lannisraurus/afm-tools/README.md

# Programme Flowchart

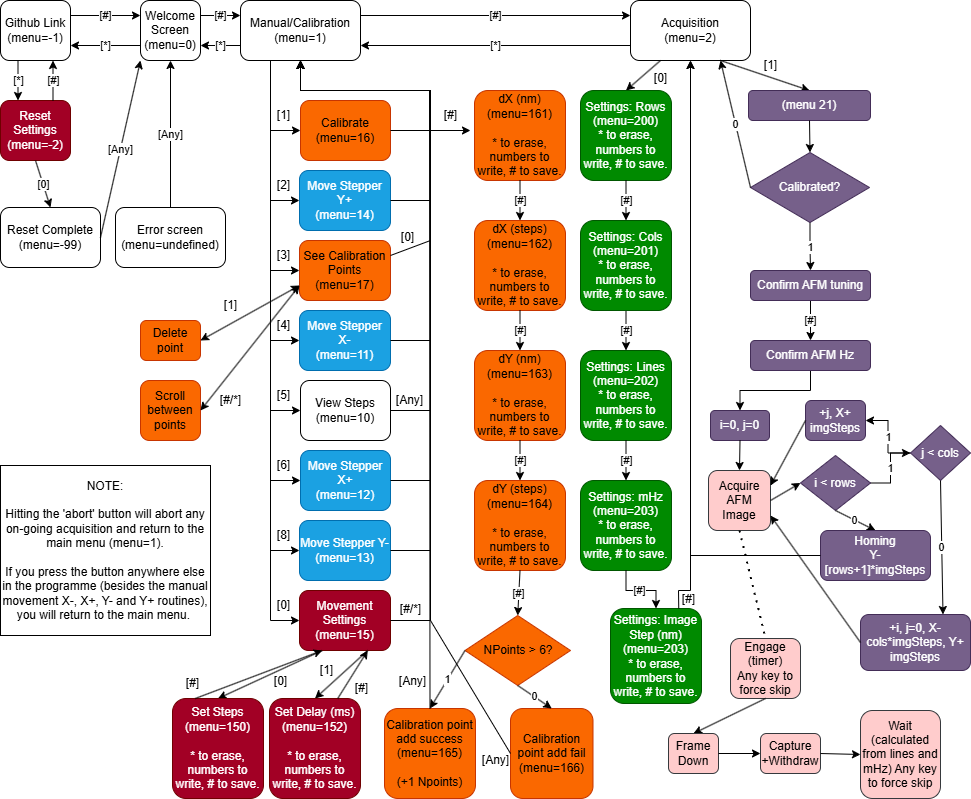
[picture p1: Models/flowchart.png]
Flowchart
