lannisraurus/afm-tools/Presentation.pdf

Automated High-Range AFM Image Acquisition

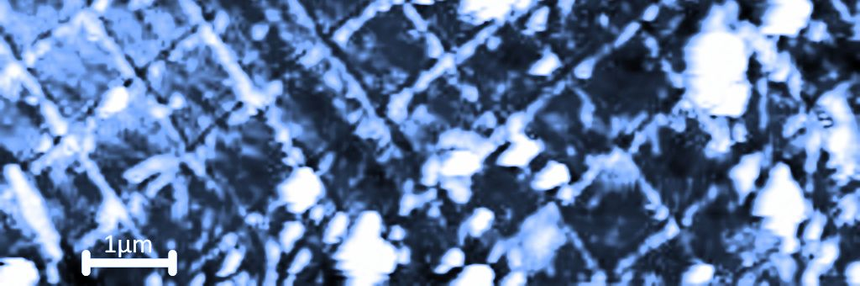
[picture p2: figure]

1st Cycle Integrated Project in Engineering Physics - Scientific Project João Francisco Oliveira Camacho (ist1106224)
Supervisor: Prof. Dr. Luís Humberto Viseu Melo

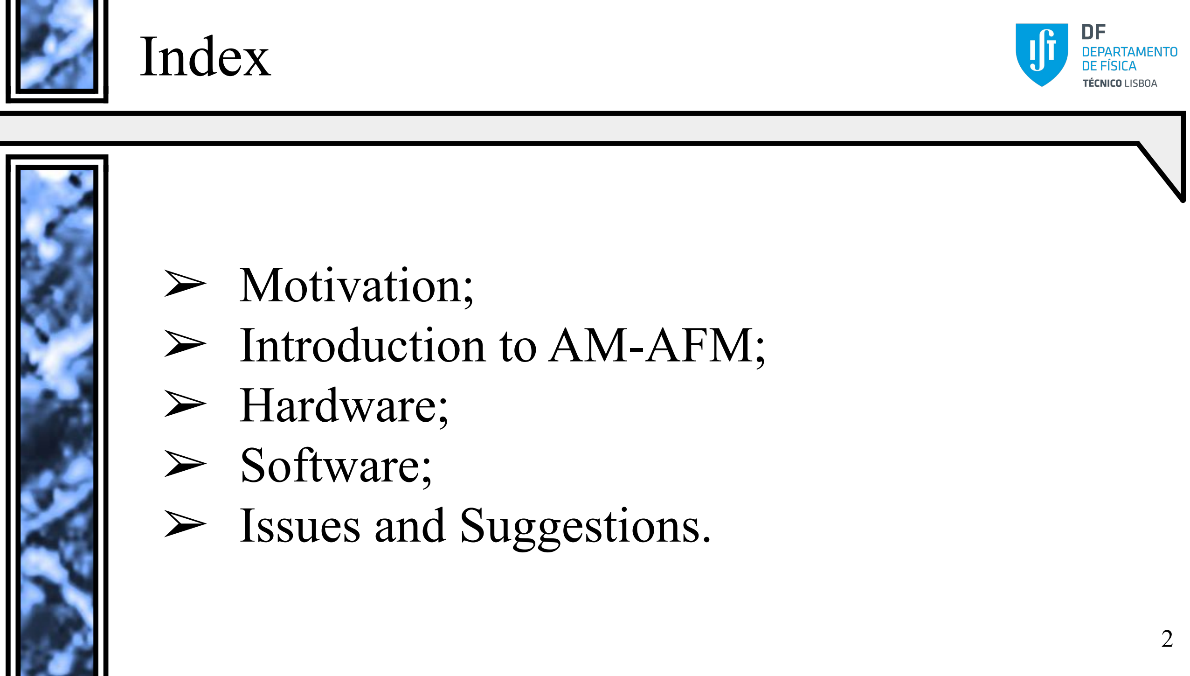
[picture p3: figure]
Index; ➢ Motivation; ➢ Introduction to AM-AFM; ➢ Hardware; ➢ Software; ➢ Issues and Suggestions.
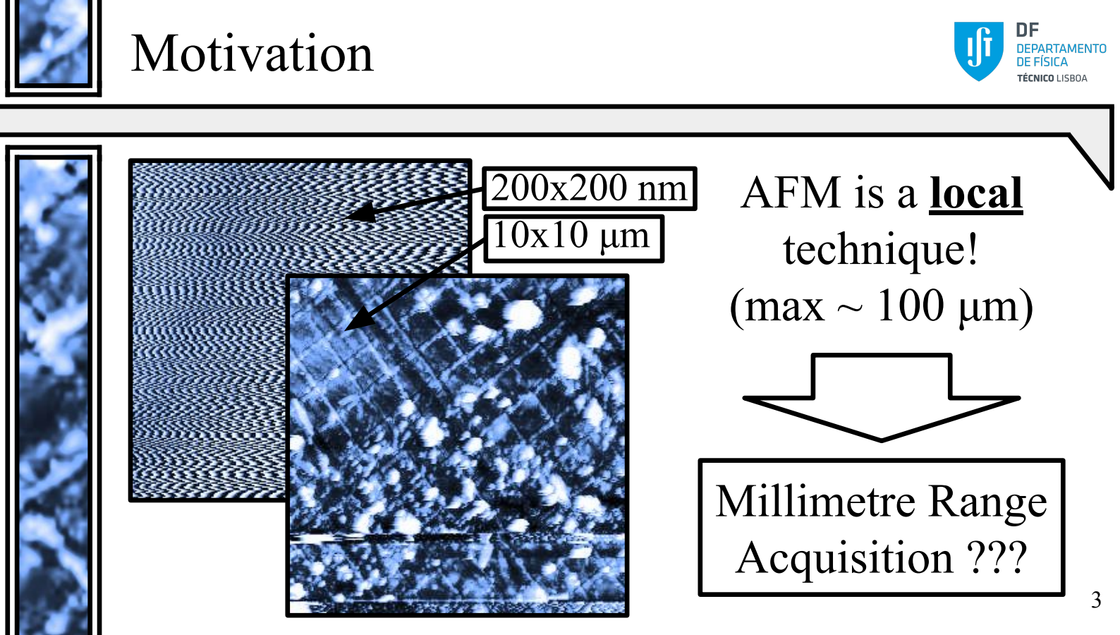
[picture p4: page 3]

### Motivation

AFM is a local
technique!
(max ~ 100 μm)

200x200 nm
10x10 μm

Millimetre Range
Acquisition ???

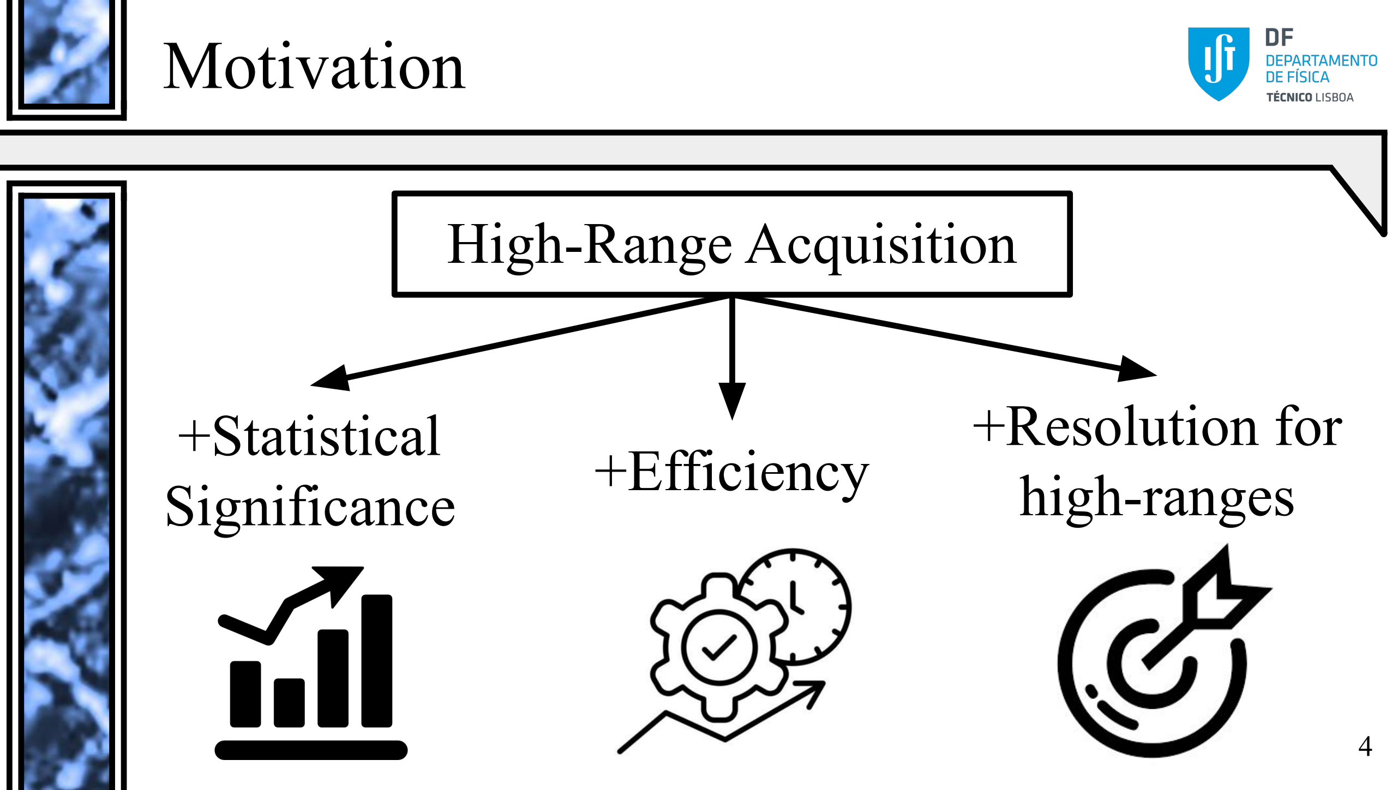
[picture p5: figure]
Motivation; High-Range Acquisition; +Statistical; Significance; +Efficiency; +Resolution for high-ranges
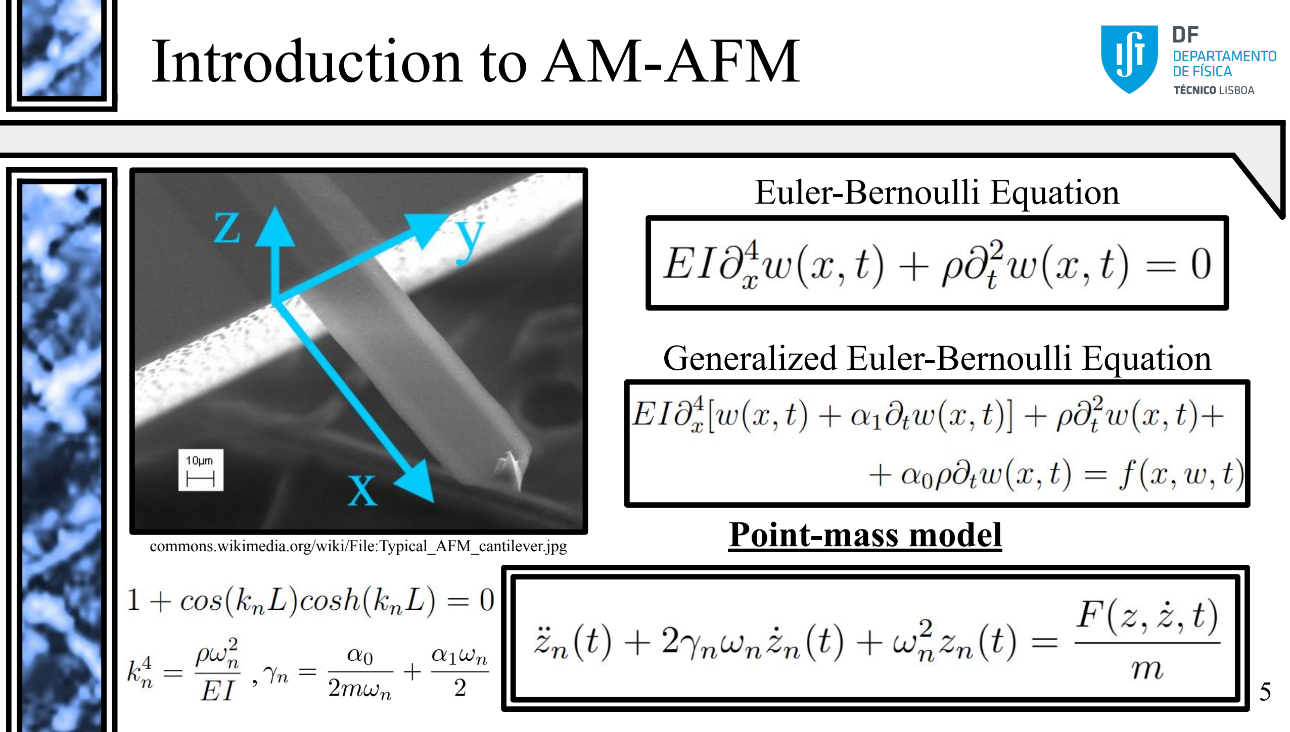
[picture p6: page 5]

### Introduction to AM-AFM

commons.wikimedia.org/wiki/File:Typical_AFM_cantilever.jpg

Euler-Bernoulli Equation

Generalized Euler-Bernoulli Equation

Point-mass model

,

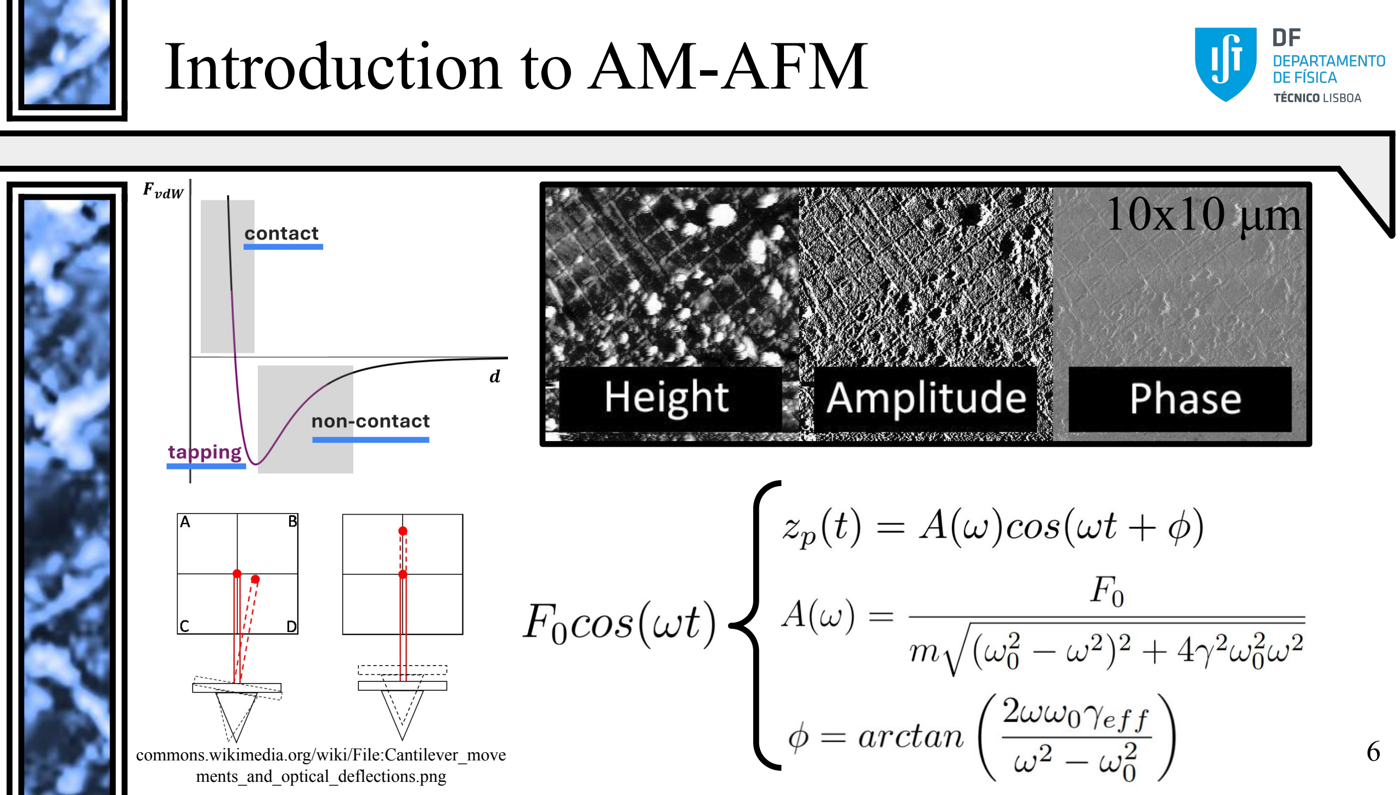
[picture p7: page 6]

### Introduction to AM-AFM

commons.wikimedia.org/wiki/File:Cantilever_move ments_and_optical_deflections.png

10x10 μm

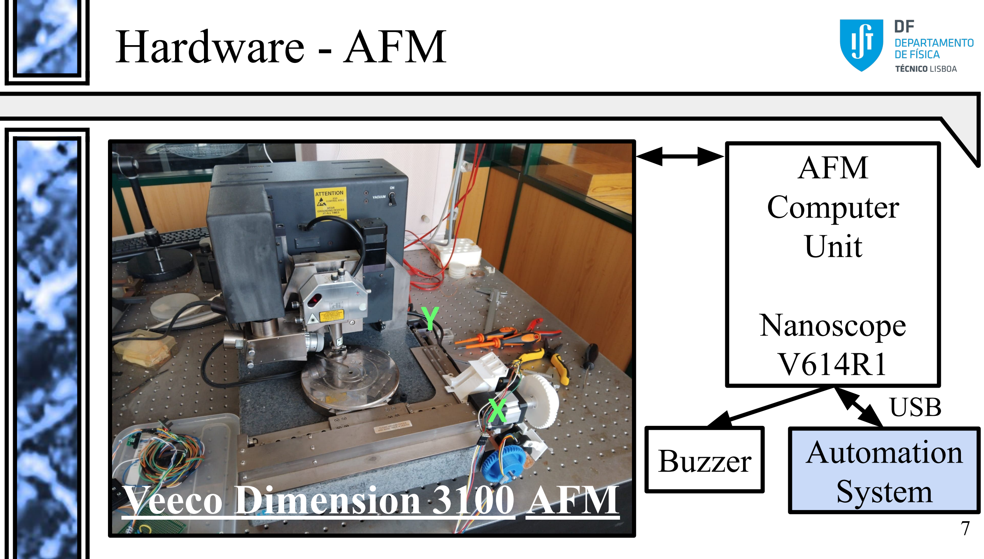
[picture p8: page 7]

### Hardware - AFM

Veeco Dimension 3100 AFM

AFM
Computer
Unit

Nanoscope
V614R1
Buzzer Automation System USB

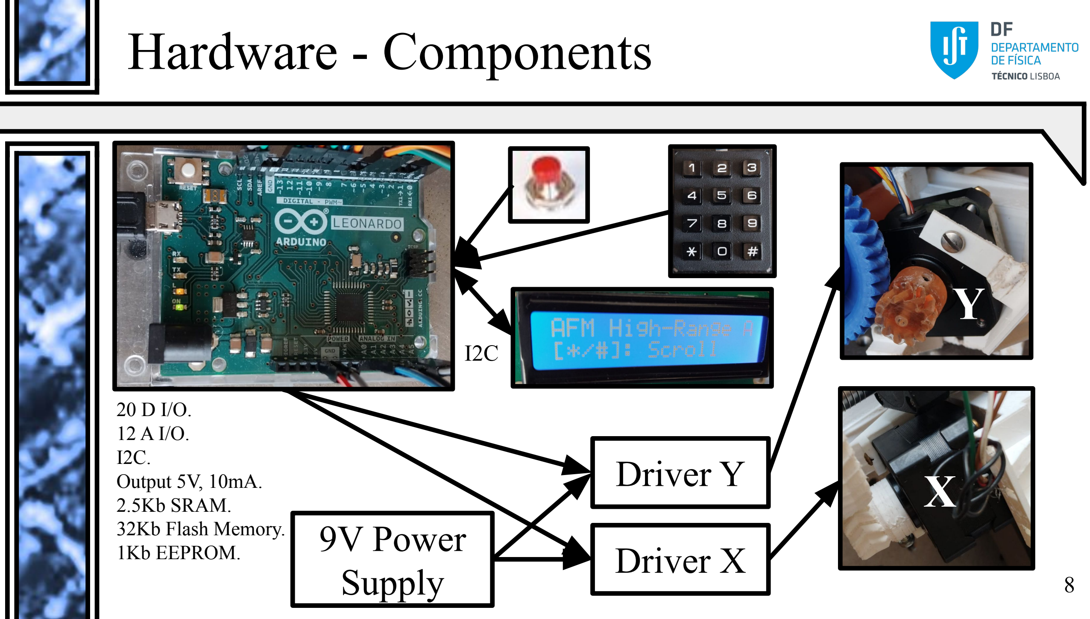
[picture p9: figure]
Hardware - Components; 20 D I/O. 12 A I/O. I2C. Output 5V, 10mA. 2.5Kb SRAM. 32Kb Flash Memory. 1Kb EEPROM.; 9V Power Supply; Driver Y; Driver X
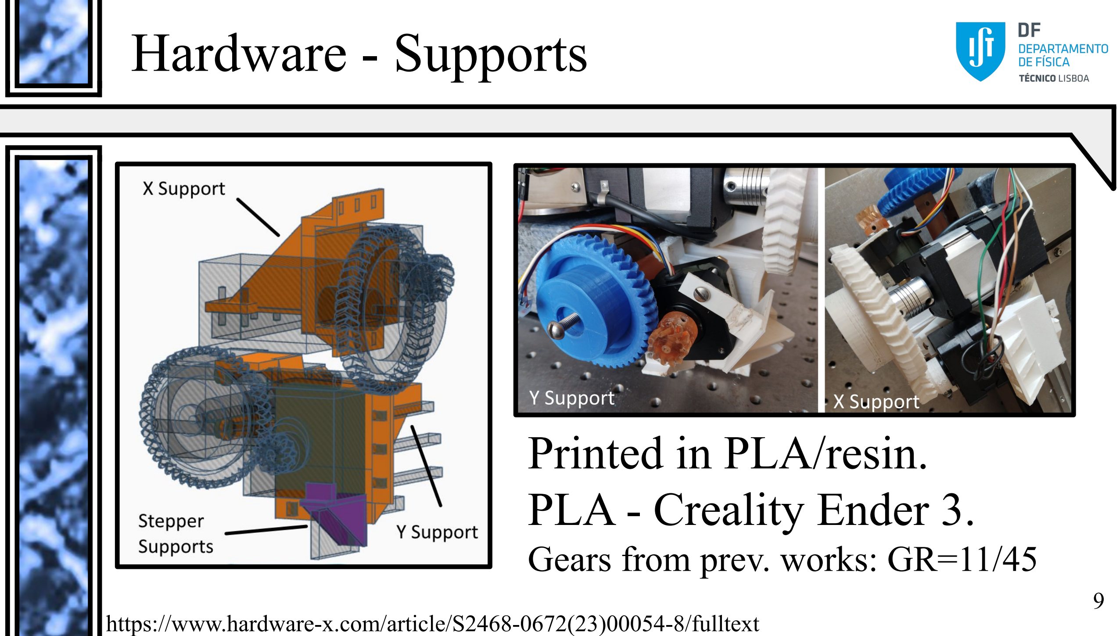
[picture p10: page 9]

### Hardware - Supports

X

Y

Printed in PLA/resin.
PLA - Creality Ender 3.
Gears from prev. works: GR=11/45

https://www.hardware-x.com/article/S2468-0672(23)00054-8/fulltext

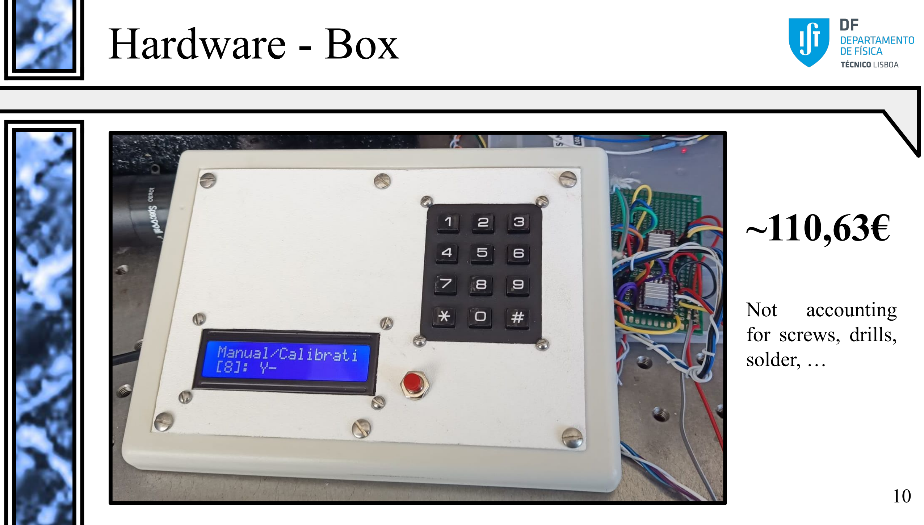
[picture p11: figure]
Hardware - Box; Not; accounting; for screws, drills, solder, …

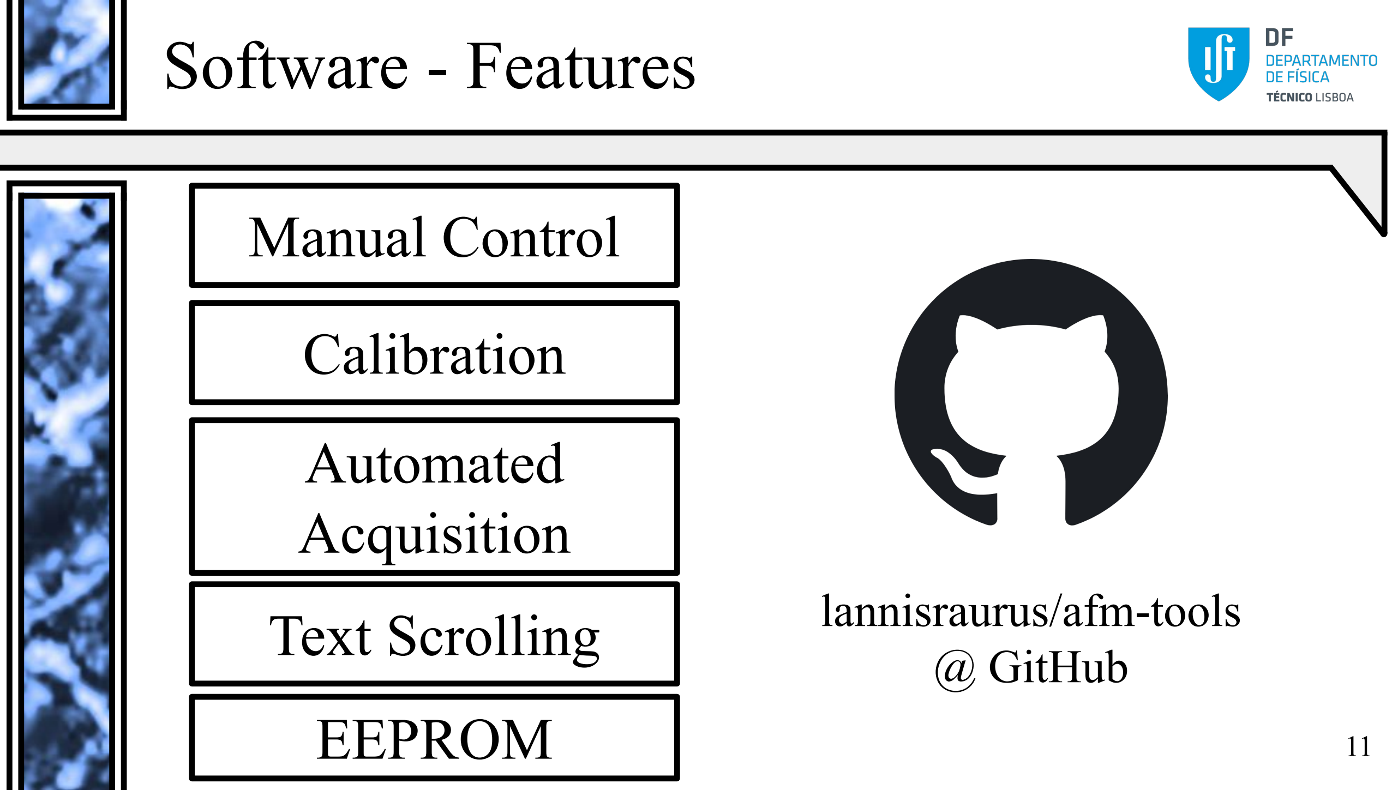
[picture p12: figure]
Software - Features; Manual Control; Calibration; Automated Acquisition; Text Scrolling; lannisraurus/afm-tools; @ GitHub; EEPROM
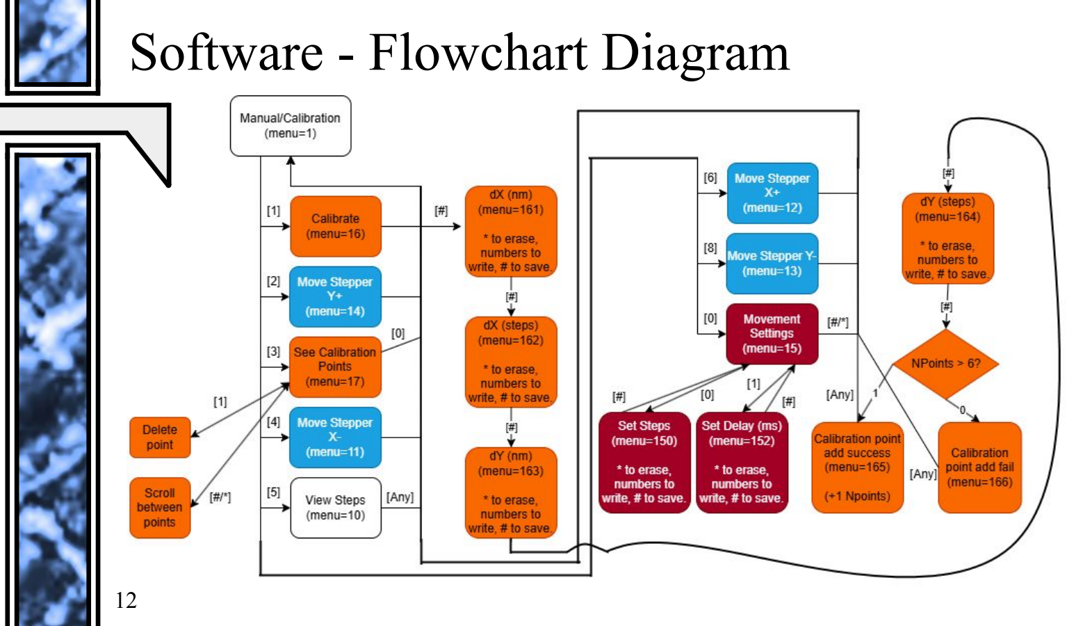
[picture p13: page 12]

X

Y

### Software - Flowchart Diagram

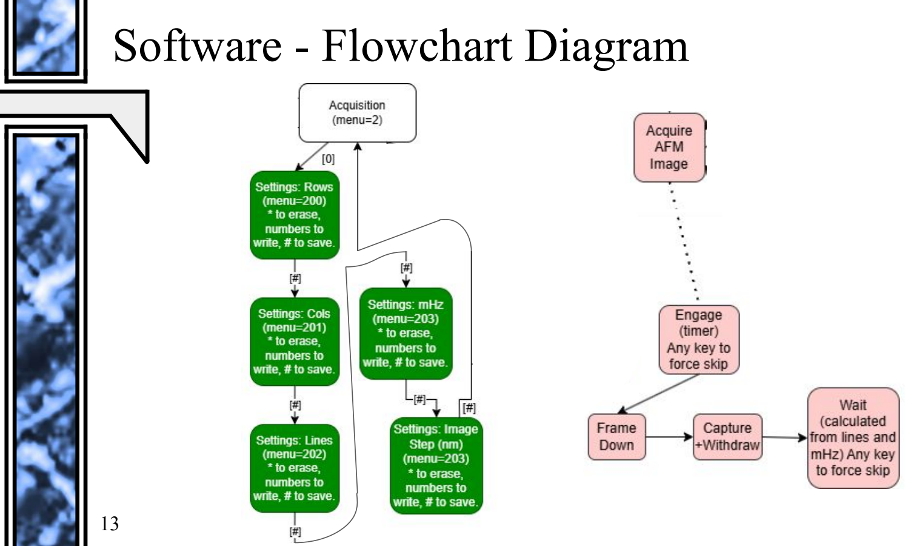
[picture p14: page 13]

### Software - Flowchart Diagram

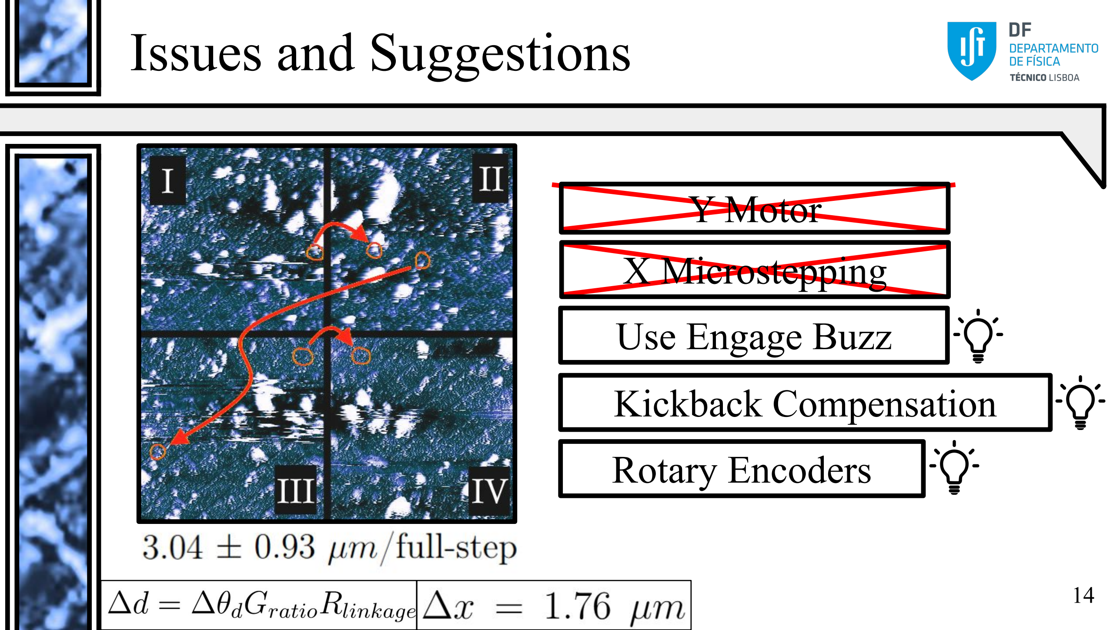
[picture p15: figure]
Issues and Suggestions; X Microstepping; Y Motor; Use Engage Buzz; Kickback Compensation; Rotary Encoders

Automated High-Range AFM Image Acquisition

1st Cycle Integrated Project in Engineering Physics - Scientific Project João Francisco Oliveira Camacho (ist1106224)
Supervisor: Prof. Dr. Luís Humberto Viseu Melo
