lannisraurus/afm-tools/Analysis/data/3dmodelspreview.png

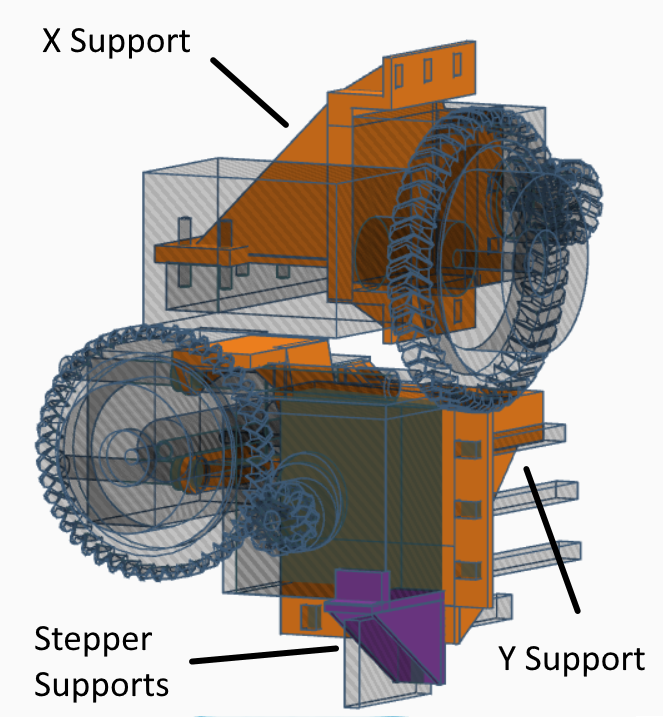
Analysis/data/3dmodelspreview.png
