lannisraurus/afm-tools/Analysis/data/015-200x200nm-view_height.jpg

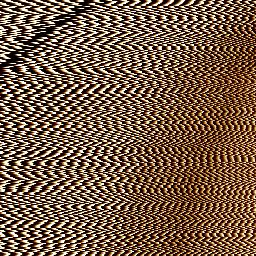
Analysis/data/015-200x200nm-view_height.jpg
