lannisraurus/afm-tools/Analysis/data/019-10x10um-view.jpg

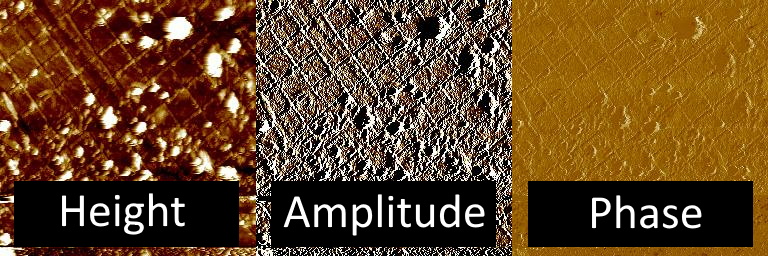
Analysis/data/019-10x10um-view.jpg
