lannisraurus/afm-tools/Analysis/data/019-10x10um-view_amplitude.jpg

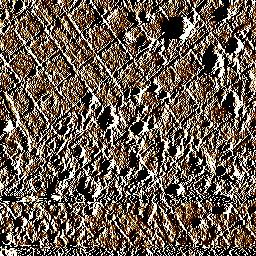
Analysis/data/019-10x10um-view_amplitude.jpg
