lannisraurus/afm-tools/Analysis/data/019-10x10um-view_height.jpg

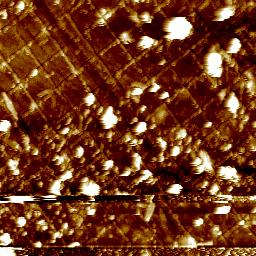
Analysis/data/019-10x10um-view_height.jpg
