lannisraurus/afm-tools/Analysis/data/020-10x10um-cal-s64-height.jpg

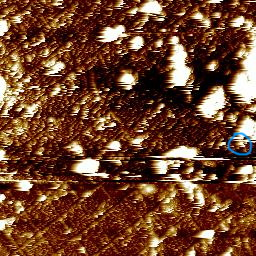
Analysis/data/020-10x10um-cal-s64-height.jpg
