lannisraurus/afm-tools/Analysis/data/021-10x10um-cal-s64-height.jpg

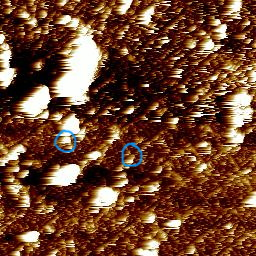
Analysis/data/021-10x10um-cal-s64-height.jpg
