lannisraurus/afm-tools/Analysis/data/022-10x10um-cal-s64-height.jpg

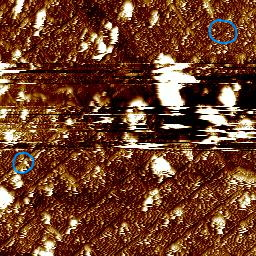
Analysis/data/022-10x10um-cal-s64-height.jpg
