lannisraurus/afm-tools/Analysis/data/023-10x10um-cal-s64-height.jpg

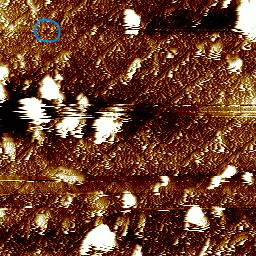
Analysis/data/023-10x10um-cal-s64-height.jpg
