lannisraurus/afm-tools/Analysis/data/025-10x10um-kb-plus-s64-height.jpg

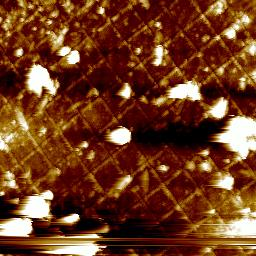
Analysis/data/025-10x10um-kb-plus-s64-height.jpg
