lannisraurus/afm-tools/Analysis/data/027-10x10um-kb-minus-s64-height.jpg

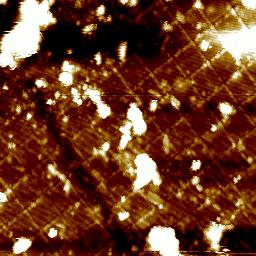
Analysis/data/027-10x10um-kb-minus-s64-height.jpg
