lannisraurus/afm-tools/Analysis/data/028-10x10um-kb-plus-s64-height.jpg

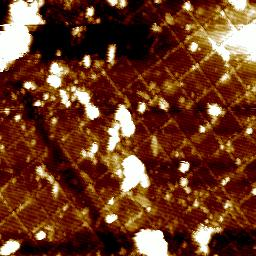
Analysis/data/028-10x10um-kb-plus-s64-height.jpg
