lannisraurus/afm-tools/Analysis/data/029-10x10um-kb-minus-s64-height.jpg

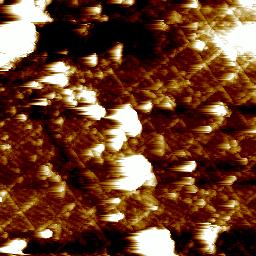
Analysis/data/029-10x10um-kb-minus-s64-height.jpg
