lannisraurus/afm-tools/Analysis/data/030-10x10um-kb-plus-s64-height.jpg

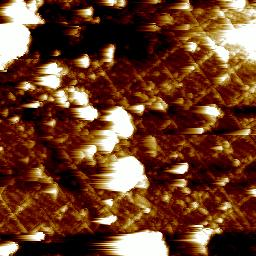
Analysis/data/030-10x10um-kb-plus-s64-height.jpg
