lannisraurus/afm-tools/Analysis/data/afm.jpg

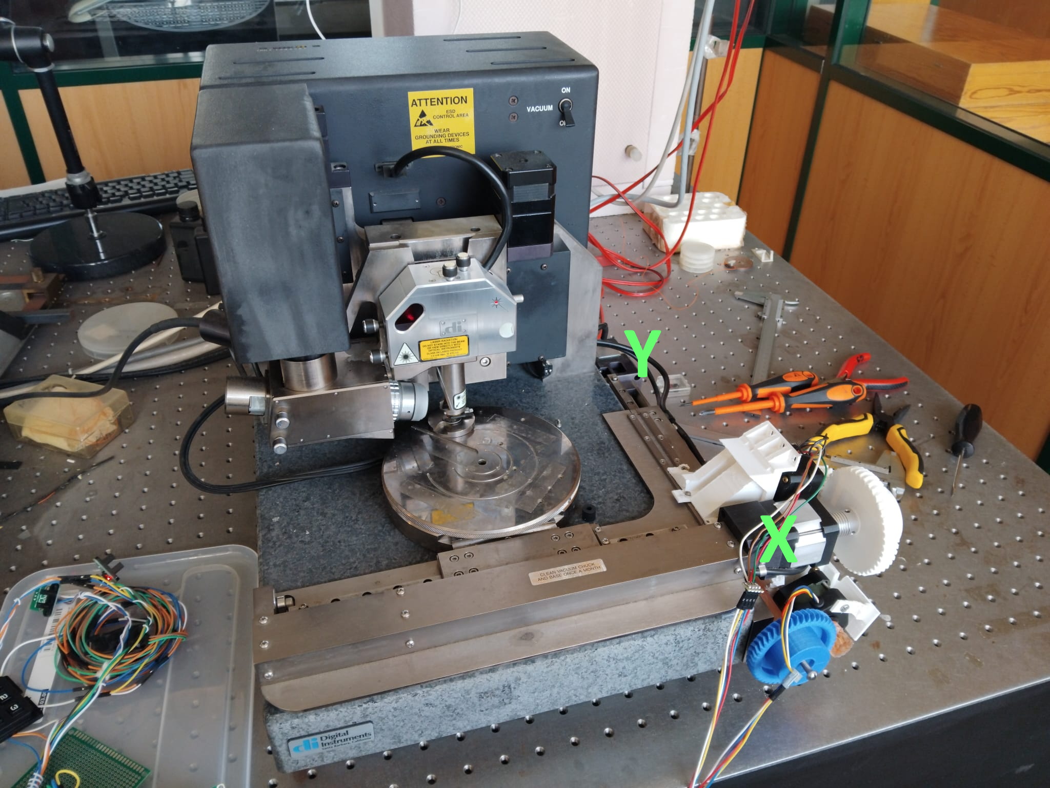
Analysis/data/afm.jpg
