lannisraurus/afm-tools/Analysis/data/CAL-SG4.jpg

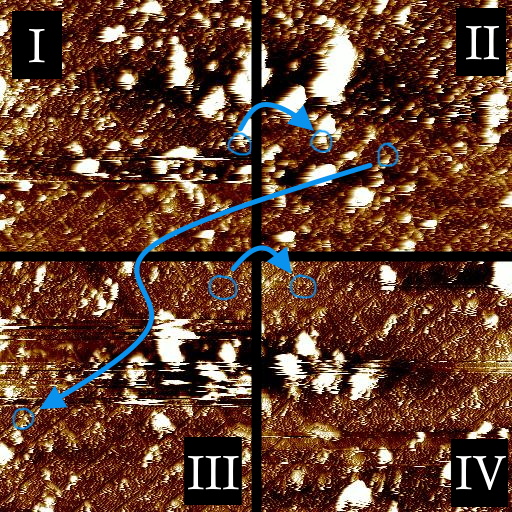
Analysis/data/CAL-SG4.jpg
