lannisraurus/afm-tools/Analysis/data/closeups.png

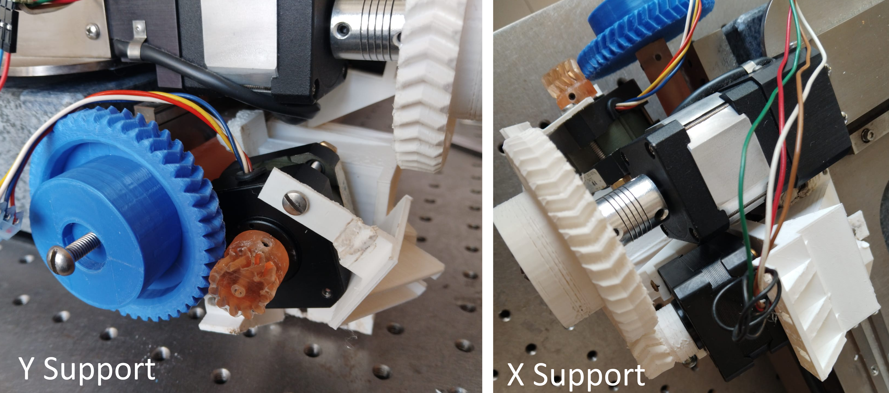
Analysis/data/closeups.png
