lannisraurus/afm-tools/Models/circuit.png

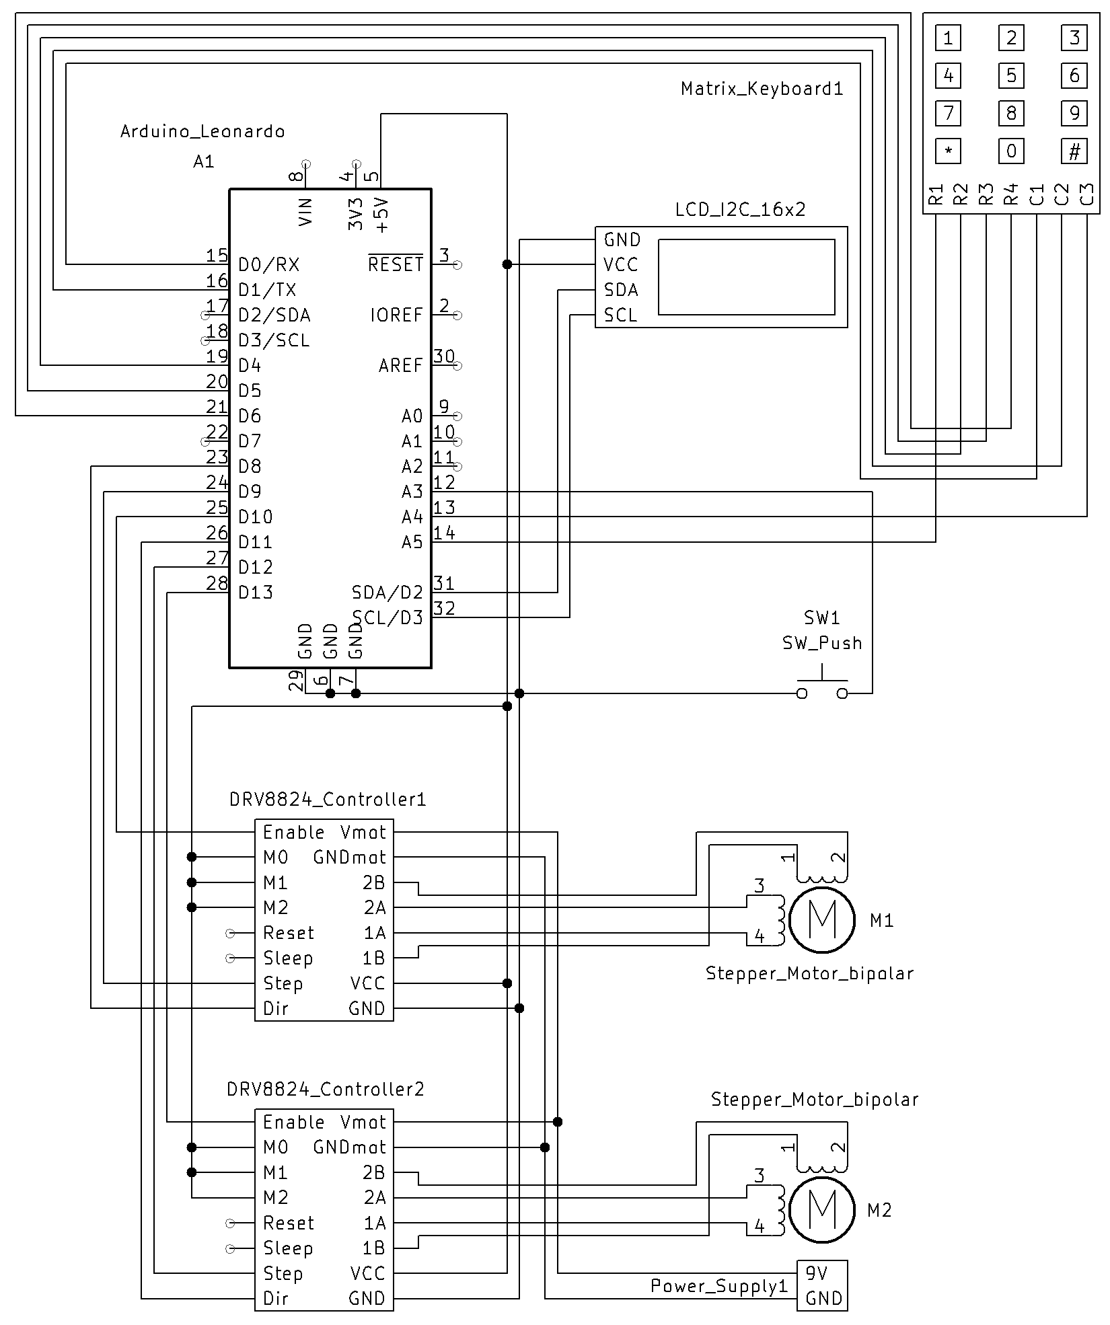
Models/circuit.png
