lannisraurus/afm-tools/3DModels/YSupport.stl

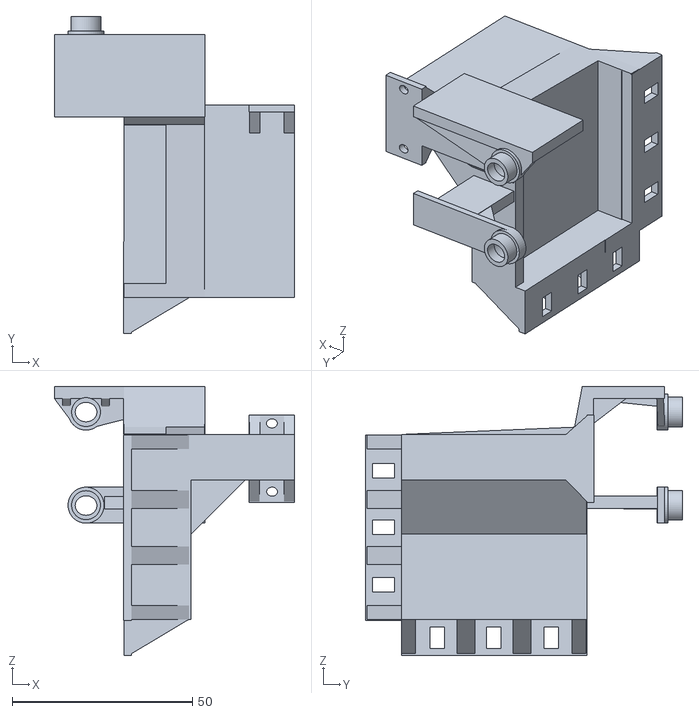
[picture p38: CAD file, 2025-06-20]
3DModels/YSupport.stl
66.6 x 87.8 x 74.6
