lannisraurus/afm-tools/AFM_Tools/cube.obj

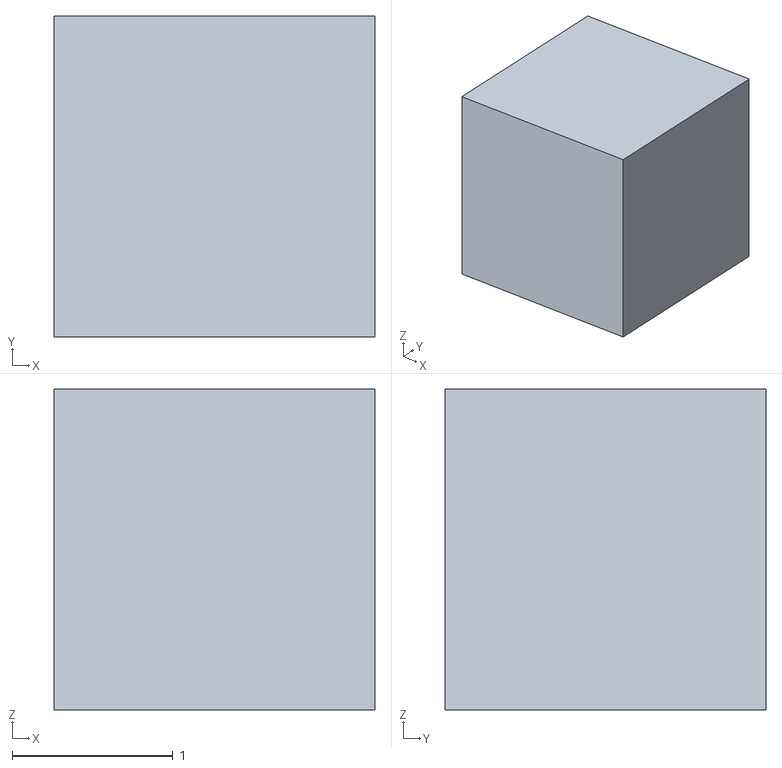
[picture p39: CAD file, 2025-03-20]
AFM_Tools/cube.obj
2.00 x 2.00 x 2.00
