lannisraurus/afm-tools/Models/axisExtension3.stl

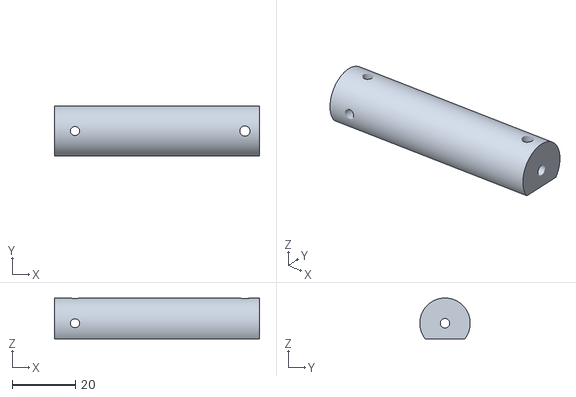
[picture p40: CAD file, 2025-06-26]
Models/axisExtension3.stl
65.0 x 16.0 x 13.0
