lannisraurus/afm-tools/3DModels/TallSupportLeft.stl

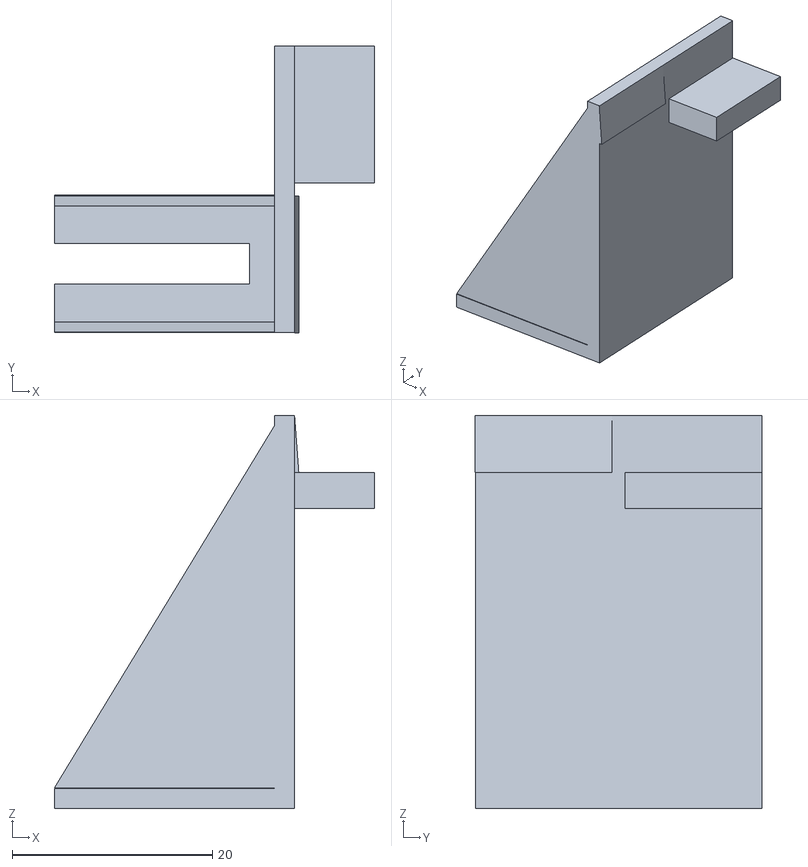
[picture p41: CAD file, 2025-06-20]
3DModels/TallSupportLeft.stl
32.0 x 28.7 x 39.3
