lannisraurus/afm-tools/3DModels/XSupport.stl

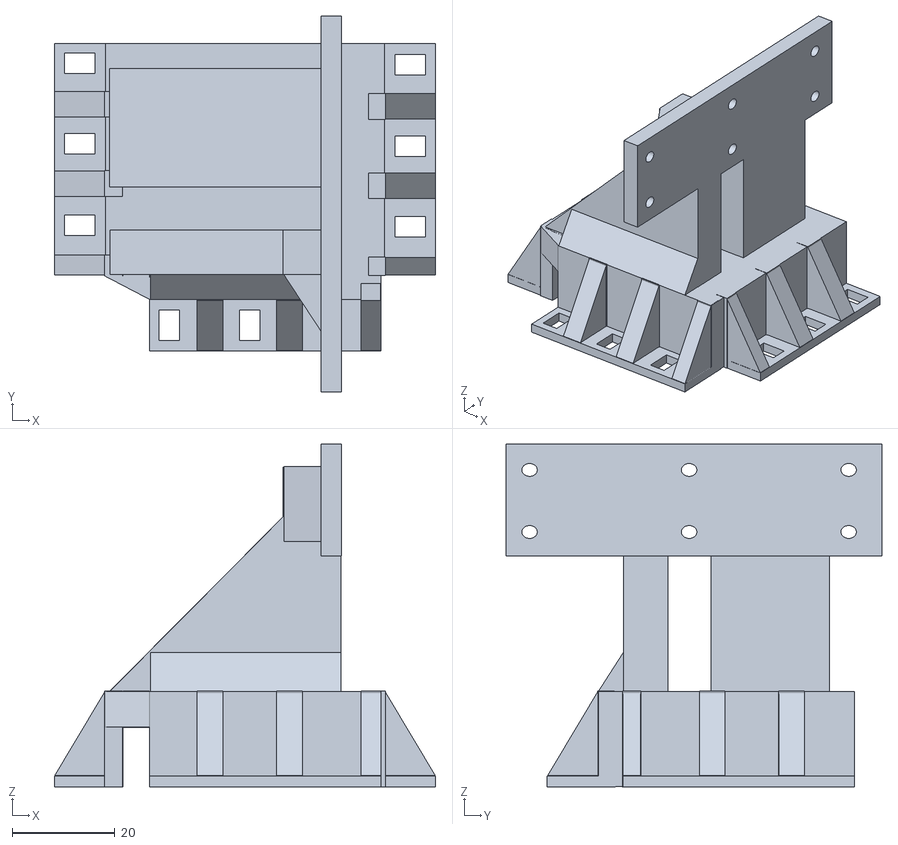
[picture p42: CAD file, 2025-06-20]
3DModels/XSupport.stl
74.4 x 73.3 x 66.9
