lannisraurus/afm-tools/3DModels/TallSupportFront.stl

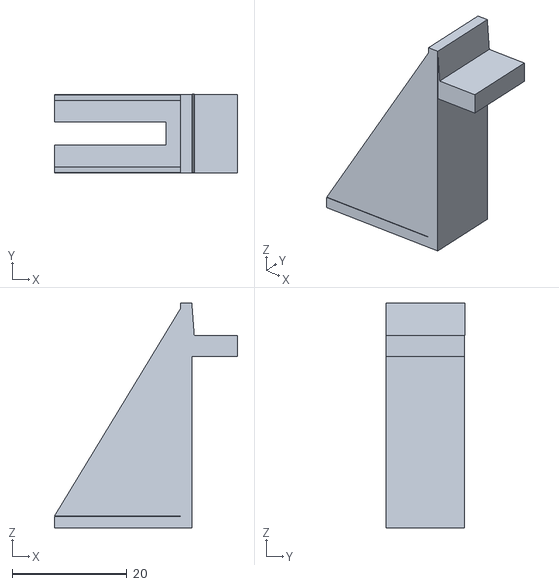
[picture p43: CAD file, 2025-06-20]
3DModels/TallSupportFront.stl
32.0 x 13.7 x 39.3
