lannisraurus/afm-tools/3DModels/ShortSupportFront.stl

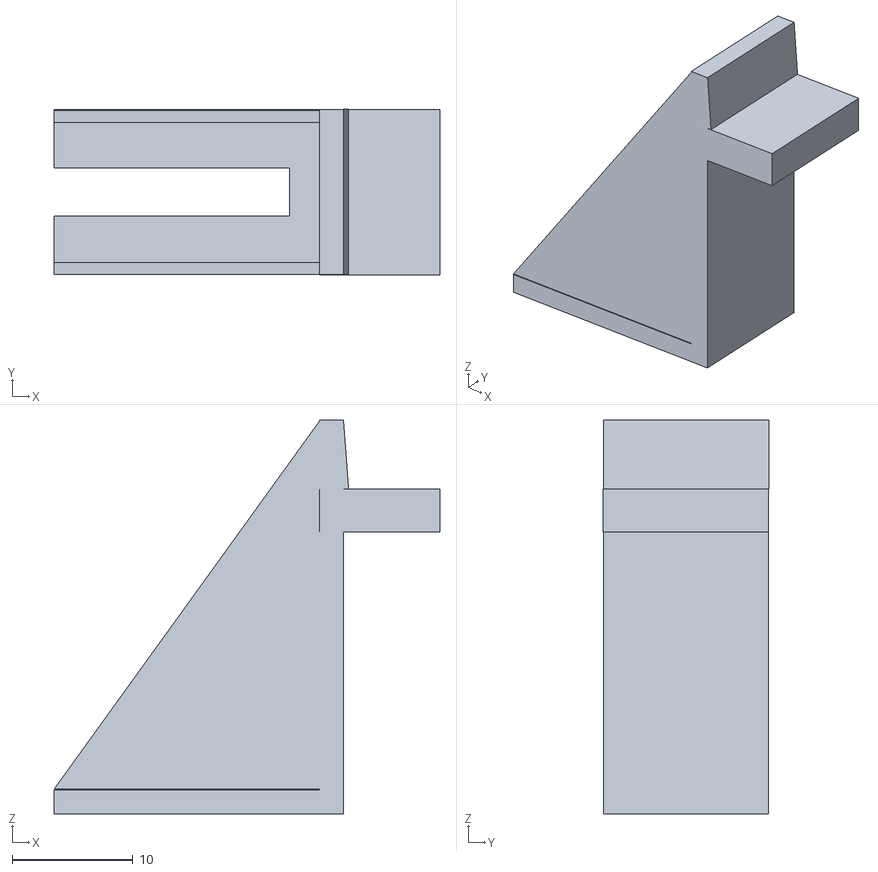
[picture p44: CAD file, 2025-06-20]
3DModels/ShortSupportFront.stl
32.0 x 13.7 x 32.7
