lannisraurus/afm-tools/(list of files, cad)

Other CAD files:
3DModels/TallSupportRight.stl
Models/TallSupportRight.stl
