lannisraurus/afm-tools/(commit log)

2025-03-20 Added XYZ axes, mouse manipulation
    [cube.obj]
2025-05-07 oganizing folders
    [cube.obj]
2025-06-17 working on mic sensor
2025-06-20 Uploading developed material
    [ShortSupportFront.stl, TallSupportFront.stl, TallSupportLeft.stl, TallSupportRight.stl, XSupport.stl, YSupport.stl, cube.obj]
2025-06-20 data bad. will retry acquisition tomorrow
    [ShortSupportFront.stl, TallSupportFront.stl, TallSupportLeft.stl, TallSupportRight.stl, XSupport.stl, YSupport.stl]
2025-06-26 data and added abort button
    [axisExtension3.stl]
2025-06-27 Organizing and adding build files
    [Circuit.kicad_pcb, Circuit.kicad_sch, ShortSupportFront.stl, TallSupportFront.stl, TallSupportLeft.stl, TallSupportRight.stl, XSupport.stl, YSupport.stl]
